gorocca/autonomousbuggypi/README.md

<h1> Autonomous buggy Raspberry Pi </h1>

Trabajo de fin de Grado para la carrera de Grado en Ingeniería Informática - Tecnologías Informáticas

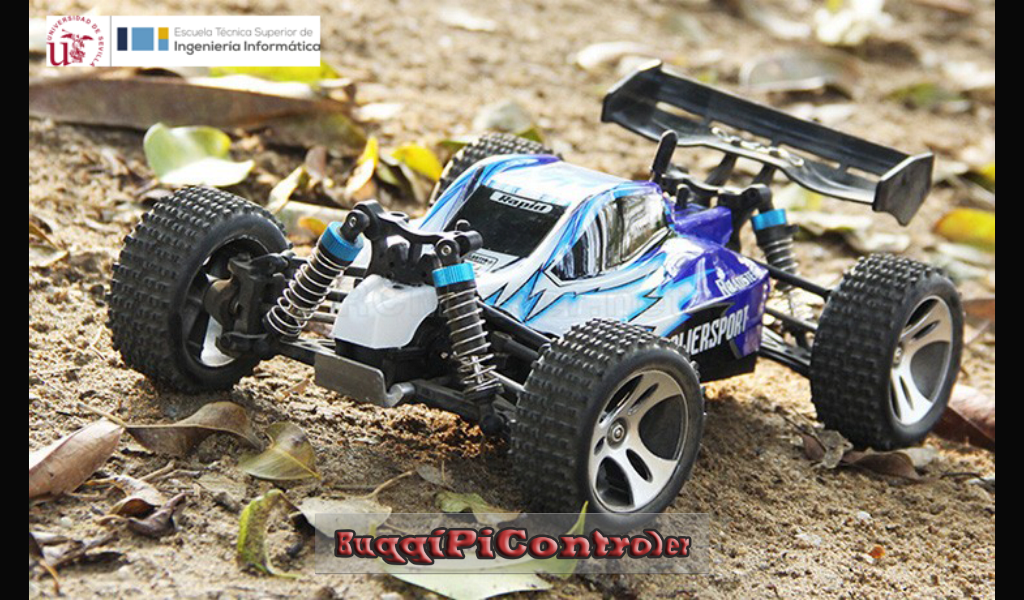
[picture p1: memoria Latex/img/inicio.png]
