gorocca/autonomousbuggypi/memoria Latex/img/IMG_1755.JPG

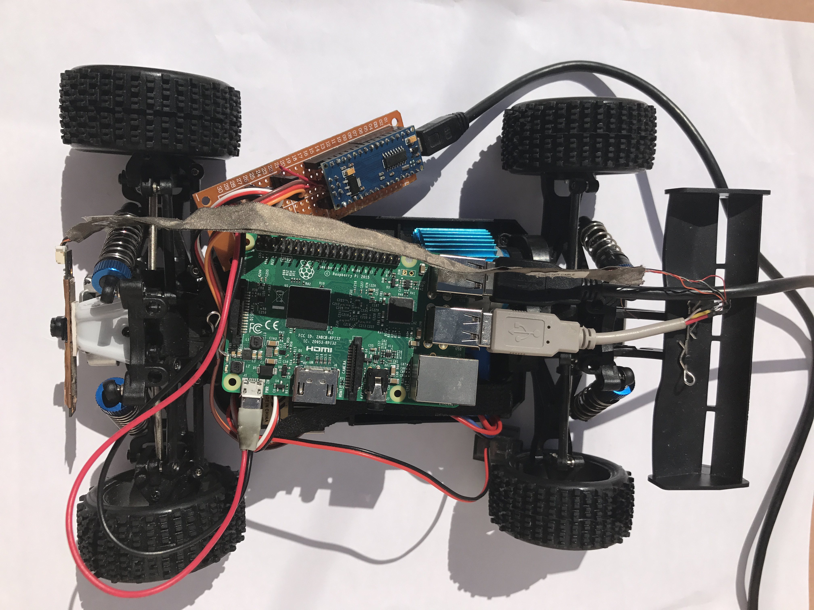
memoria Latex/img/IMG_1755.JPG
