gorocca/autonomousbuggypi/memoria Latex/img/IMG_1769.JPG

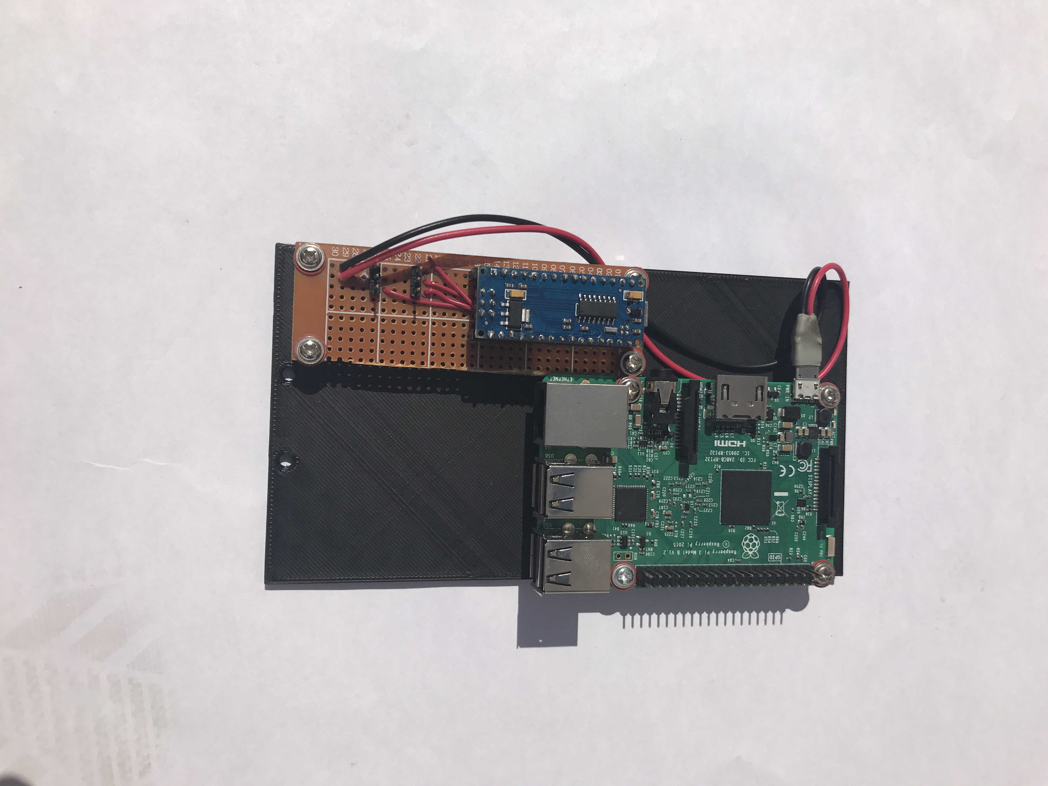
memoria Latex/img/IMG_1769.JPG
