gorocca/autonomousbuggypi/(list of files, cad)

Other CAD files:
appAndroid/app/src/main/jni/jpeg8d/jdosamsc.obj
appAndroid/app/src/main/jni/jpeg8d/jdosabcc.obj
