gorocca/autonomousbuggypi/memoria Latex/img/arduinoCambios.png

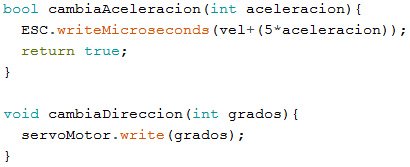
memoria Latex/img/arduinoCambios.png
