gorocca/autonomousbuggypi/(commit log)

2016-10-25 Añadido el proyecto python
2016-10-25 Control motor añadido
2016-10-25 Cambios en el control motor
2016-10-25 Modificación en el control motor
2017-01-18 Añadido código de control del arduino
2017-05-15 Añadida aplicación Android
    [jconfig.cfg, jconfig.txt, jdosabcc.obj, jdosamsc.obj]
2017-05-25 Añadido la detección de personas
2017-05-26 Añadida la conexión de instrucciones desde el script de deteccion de personas
2017-05-26 Añadida la memoria en latex
2017-05-26 Modificaciones de la memoria
2017-05-27 Modificado el detector de personas ante la presencia de errores
2017-06-08 Fallo GPIO arreglado y señal de fin detectada
    [servidor.py]
2017-06-11 Nueva versión de la memoria
2017-06-18 Modificaciones en el readme
2017-06-20 Nueva version de la memoria
